FlavioDB/FPGA-Based-BLDC-Motor-Controller-with-RISC-V-SoC/Screenshots_Waveforms/Brakes/Brakes brain.jpg

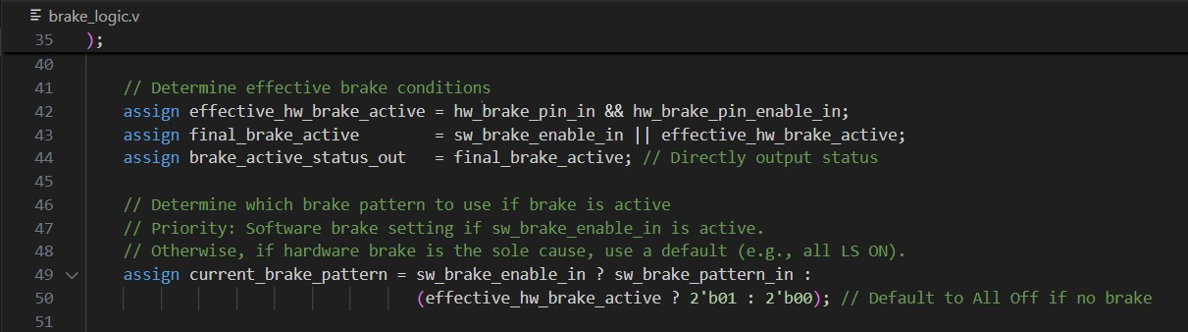
Screenshots_Waveforms/Brakes/Brakes brain.jpg
