FlavioDB/FPGA-Based-BLDC-Motor-Controller-with-RISC-V-SoC/README.txt

Francesco Tassi 2359266
Flavio Davide Borriello 2359270
Professor Jiang Lei - Intelligent Chip Design

In the Appendix, the following files are available:
• Tang Primer 20k and BLDC H-Bridge Schematics
• Constraints file (.cst) for our project
• Class notes showing the project’s structure
• various main.c files that have been used for the various simulations. It's enough to substitute them to the main.c file inside the project folder to try the different verions out 

In the folder e203BLDCfaf-main - current version we have, of course, the whole project with all .v and .c files.

July 2025
