FlavioDB/FPGA-Based-BLDC-Motor-Controller-with-RISC-V-SoC/Appendix/Project Documentation and notes.docx

# Understanding the Hummingbird E203 and its Role

- The Brain: The E203 is a 32-bit RISC-V processor core. Think of it as the CPU of your system-on-chip (SoC). It will execute the C code you write to manage the BLDC motor (e.g., set speed, direction, mode).
- Bus Master: In the context of the ICB, the E203 core acts as the master. This means it initiates all communication transactions (reads and writes) to peripherals like your BLDC controller.
- Memory-Mapped Peripherals: The E203 interacts with peripherals by treating their control and status registers as locations in its memory map. When your C code writes to a specific memory address, the E203 translates this into an ICB write transaction to that address. Your BLDC controller will be assigned a range of these addresses.

The ICB (Internal Chip Bus) Protocol

The ICB is a relatively simple, synchronous, point-to-point (or shared, with an arbiter) bus designed for on-chip communication. Your BLDC controller will be an ICB slave.

Here are the key signals you'll need to implement in your Verilog module for the slave interface:

Signals from Master (E203) to Slave (Your BLDC Controller):

- icb_cmd_valid (Input to your module):
  - When asserted (HIGH), it indicates that the master (E203) is presenting a valid command (address and potentially write data) on the bus.
- icb_cmd_addr[AWIDTH-1:0] (Input to your module):
  - The address target of the command. AWIDTH is the address bus width (typically 32 bits for E203, but your peripheral will only look at a few lower bits to select internal registers).
- icb_cmd_read (Input to your module):
  - When HIGH, it's a read command. When LOW, it's a write command.
- icb_cmd_wdata[DWIDTH-1:0] (Input to your module):
  - The data to be written if icb_cmd_read is LOW. DWIDTH is the data bus width (typically 32 bits).

Signal from Slave (Your BLDC Controller) to Master (E203):

- icb_cmd_ready (Output from your module):
  - When asserted (HIGH), it indicates that your slave peripheral is ready to accept the command currently presented by the master. This is crucial for flow control. If your peripheral is busy, it can de-assert icb_cmd_ready to make the master wait.
  - A transaction on the command channel happens on a clock edge when both icb_cmd_valid and icb_cmd_ready are HIGH.

Signals from Slave (Your BLDC Controller) to Master (E203) for Response:

- icb_rsp_valid (Output from your module):
  - When asserted (HIGH), it indicates that your slave is providing a valid response (e.g., read data or write acknowledgement) to the master.
- icb_rsp_rdata[DWIDTH-1:0] (Output from your module):
  - The data being returned to the master for a read command. For a write command, this data is usually ignored by the master, but it's good practice to drive it to zeros or a defined value.

Signal from Master (E203) to Slave (Your BLDC Controller) for Response:

- icb_rsp_ready (Input to your module):
  - When asserted (HIGH), it indicates that the master is ready to accept the response from your slave. This is also for flow control on the response channel.
  - A transaction on the response channel happens on a clock edge when both icb_rsp_valid and icb_rsp_ready are HIGH.

How Your BLDC Controller Acts as an ICB Slave:

1. Address Decoding:
  - Your module will be assigned a base address in the E203's memory map (e.g., 0x10040000 as seen in the example report for a UART, page 23, u_sirv_uart1). Your peripheral will have a similar entry.
  - When icb_cmd_valid is high, your module will check if the upper bits of icb_cmd_addr match its assigned base address.
  - If they match, it knows the command is for it. The lower bits of icb_cmd_addr (e.g., icb_cmd_addr[3:2] if your registers are 4-byte aligned and you have a few registers) will be used to select which specific internal register within your BLDC controller is being accessed.
2. Handling Write Transactions:
  - Master asserts icb_cmd_valid, icb_cmd_addr (to your peripheral), icb_cmd_wdata, and sets icb_cmd_read = 0.
  - Your slave logic decodes the address. If the address is for one of your writable registers and you are ready, you assert icb_cmd_ready.
  - On the next rising clock edge where icb_cmd_valid and icb_cmd_ready are both high, your logic latches icb_cmd_wdata into the selected internal register.
  - Your slave then needs to generate a response. Typically for a write, this is just an acknowledgement. You assert icb_rsp_valid. The master asserts icb_rsp_ready when it's ready for the response. The icb_rsp_rdata is often not critical for writes but can indicate success/failure if your bus protocol defines it.
3. Handling Read Transactions:
  - Master asserts icb_cmd_valid, icb_cmd_addr (to your peripheral), and sets icb_cmd_read = 1.
  - Your slave logic decodes the address. If the address is for one of your readable registers and you are ready for the command, assert icb_cmd_ready.
  - On the clock edge where icb_cmd_valid and icb_cmd_ready are high, the command is accepted.
  - Your slave logic then retrieves the data from the selected internal register.
  - You place this data on icb_rsp_rdata and assert icb_rsp_valid.
  - The master, when ready, asserts icb_rsp_ready. On the clock edge where both are high, the master captures icb_rsp_rdata.

Practical Implementation - icb_interface.v

- The Verilog module that handles this ICB slave logic is often called something like icb_slave_if.v or, as I suggested, icb_interface.v within your bldc_controller.v.
- The previous student's report on page 22 shows an example snippet of ICB_SlaveIF.v. This is a very good reference for the state machine and logic required to handle the valid/ready handshakes for both command and response channels.
  - Notice the cmd_valid_i (input icb_cmd_valid) and cmd_ready_o (output icb_cmd_ready).
  - And rsp_valid_o (output icb_rsp_valid) and rsp_ready_i (input icb_rsp_ready).
  - It internally generates signals like write_ena (write enable for your registers) and read_ena when a valid transaction for your peripheral occurs.

Key Design Steps for Your ICB Interface:

1. Define Your Register Map: This is absolutely critical and should be done before you finalize the ICB Verilog. You need to know:
  - How many registers do you need?
  - What is the address offset of each register from your peripheral's base address?
  - Are they read-only, write-only, or read-write?
  - What are the bitfields within each register? (e.g., Control register: bit 0 = enable, bits 4:1 = mode, etc.)
2. Implement Address Decoder: Logic that checks if icb_cmd_addr falls within your peripheral's range and then uses the lower bits to select an internal register.
3. Implement Read/Write Logic:
  - For writes: Use the decoded address and a write strobe (derived from icb_cmd_valid, icb_cmd_ready, and !icb_cmd_read) to update the target register with icb_cmd_wdata.
  - For reads: Use the decoded address to select data from the target register and output it on icb_rsp_rdata.
4. Implement Handshake Logic: Manage icb_cmd_ready and icb_rsp_valid correctly. A common approach is to make icb_cmd_ready high by default if the peripheral is not busy and the address is recognized. icb_rsp_valid is asserted once read data is available or a write has been processed.

Next Immediate Step:

Before we dive into the Verilog for the ICB interface itself, let's solidify your register map. Based on the project requirements and the previous report (page 26), what registers and bitfields do you think you'll need for your BLDC controller? Sketching this out will make the ICB interface design much clearer.

For example:

- 0x00: Control Register (RW)
  - bit 0: enable_motor
  - bit 1: direction
  - bits [3:2]: mode (00=static, 01=PWM, 10=SPWM)
- 0x04: Period Register (RW)
  - bits [15:0]: period_value (for timer or step duration)
- 0x08: Duty Cycle / OC1 Register (RW)
  - bits [15:0]: duty_value
- 0x0C: Dead Zone Register (RW)
  - bits [7:0]: dead_zone_cycles
- 0x10: Status Register (RO)
  - bit 0: break_active_status

# Verilog Code

## General

Let's assume your top-level module is bldc_controller.v.

1. icb_interface.v (ICB Slave Interface)
  - Purpose: Handles all communication with the E203 processor via the ICB bus. It decodes addresses, manages read/write operations to your internal registers, and implements the valid/ready handshaking.
  - Key Inputs:
    - clk (system clock, e.g., 27MHz)
    - rst_n (reset)
    - icb_cmd_valid, icb_cmd_addr, icb_cmd_read, icb_cmd_wdata (from E203)
    - icb_rsp_ready (from E203)
    - reg_read_data_muxed (data from your register file for read operations)
  - Key Outputs:
    - icb_cmd_ready (to E203)
    - icb_rsp_valid, icb_rsp_rdata (to E203)
    - reg_write_en (to register file, indicates a write to a register)
    - reg_write_addr_sel (to register file, selected register address bits)
    - reg_write_data (to register file, data to be written)
    - reg_read_addr_sel (to register file, selected register address bits for reading)
  - Internal Logic: Address decoding, state machine for ICB protocol.
2. register_file.v (Configuration & Status Registers)
  - Purpose: Holds all the software-configurable parameters (like mode, period, dead-zone value) and status information (like brake active).
  - Key Inputs:
    - clk
    - rst_n
    - reg_write_en, reg_write_addr_sel, reg_write_data (from icb_interface)
    - reg_read_addr_sel (from icb_interface)
    - hw_status_inputs (e.g., break_pin_status, current FSM state if needed for status registers)
  - Key Outputs:
    - reg_read_data_muxed (to icb_interface, selected register's data)
    - Individual register outputs (e.g., control_reg_out, period_reg_out, deadzone_reg_out) to other modules.
  - Internal Logic: A set of registers. Multiplexer to select read data based on reg_read_addr_sel. Logic to update registers on reg_write_en.
3. clock_prescaler.v (Optional, but likely needed)
  - Purpose: To generate a slower clock for your main timer/PWM logic if the system clock (e.g., 27MHz) is too fast for the desired PWM carrier frequencies (e.g., target 20-50kHz for PWM). The previous report used a 34kHz clock.
  - Key Inputs:
    - clk_in (e.g., 27MHz)
    - rst_n
    - (Optional) divisor_value (if you want it configurable, though often fixed)
  - Key Outputs:
    - clk_out (e.g., 34kHz, this will be the pwm_clk or timer_clk)
  - Internal Logic: A counter that divides the input clock.
4. main_timer.v (16-bit Counter)
  - Purpose: The core timer that counts up to a period value. This period can define a PWM cycle, a step in 6-step commutation, or be used for SPWM timing.
  - Key Inputs:
    - pwm_clk (from clock_prescaler or system clk if no prescaler)
    - rst_n
    - enable (from register_file control register)
    - load_period (a pulse to load a new period value)
    - period_value_in (from register_file)
  - Key Outputs:
    - timer_count_out (current 16-bit count value)
    - period_match_tick (pulse when timer reaches period_value_in - 1 and wraps)
  - Internal Logic: A 16-bit counter, comparator for period match.
5. pwm_waveform_generator.v (or output_logic.v)
  - Purpose: This is the most complex module. It takes the timer count, OC values (duty cycle settings), mode selection, and direction to generate the 6 ideal (pre-dead-zone) PWM signals for the U, V, W phases.
  - Key Inputs:
    - pwm_clk
    - rst_n
    - enable (from register_file)
    - mode (Static, PWM, SPWM - from register_file)
    - direction (from register_file)
    - timer_count_out (from main_timer)
    - period_match_tick (from main_timer)
    - oc_value_U, oc_value_V, oc_value_W (these are the effective duty cycle controls for each phase, derived from registers or SPWM logic)
    - period_value_for_pwm (current period for PWM generation, could be from main_timer or a separate register for SPWM)
    - (For SPWM) sine_data_U, sine_data_V, sine_data_W (from spwm_engine)
  - Key Outputs:
    - ideal_pwm_hs_u, ideal_pwm_ls_u
    - ideal_pwm_hs_v, ideal_pwm_ls_v
    - ideal_pwm_hs_w, ideal_pwm_ls_w (Note: ideal_pwm_ls_x is simply !ideal_pwm_hs_x before dead-zone insertion)
  - Internal Logic:
    - State machine for 6-step commutation (for Static and PWM modes).
    - Comparators: timer_count_out < oc_value_X to generate basic PWM.
    - Logic to select active phases based on commutation step and direction.
    - Logic to modulate PWM duty based on sine_data_X in SPWM mode.
6. spwm_engine.v (SPWM Specific Logic - if separated)
  - Purpose: Generates the three phase-shifted sinusoidal modulation values for SPWM mode.
  - Key Inputs:
    - pwm_clk
    - rst_n
    - enable (from register_file, specifically when in SPWM mode)
    - spwm_frequency_control (derived from a register, to set the 1-10Hz output sine frequency)
    - spwm_amplitude_control (derived from a register)
  - Key Outputs:
    - sine_data_U, sine_data_V, sine_data_W (to pwm_waveform_generator)
  - Internal Logic:
    - sine_rom.v (instantiated internally or accessed)
    - Angle counters/accumulators for each phase (offset by 120 degrees).
    - Logic to fetch values from ROM based on current angles.
    - Logic to scale sine values by amplitude control.
    - The phase_generator.v from page 34 of the report would fit here.
7. dead_zone_inserter.v
  - Purpose: Takes the 3 pairs of ideal complementary PWM signals and inserts the configured dead time.
  - Key Inputs:
    - pwm_clk
    - rst_n
    - ideal_pwm_hs_u, ideal_pwm_ls_u (and for V, W) (from pwm_waveform_generator)
    - dead_zone_cycles (from register_file)
  - Key Outputs:
    - final_pwm_hs_u, final_pwm_ls_u (and for V, W) (these go to the FPGA output pins)
  - Internal Logic: Delay logic. When HS turns off, LS is delayed from turning on. When LS turns off, HS is delayed from turning on. Typically uses small counters or shift registers per phase.
8. brake_logic.v
  - Purpose: Overrides the normal PWM outputs when an emergency brake signal is asserted.
  - Key Inputs:
    - break_input_pin (from FPGA top-level input)
    - final_pwm_hs_u_pre_brake, final_pwm_ls_u_pre_brake (etc. for V, W - these are the outputs from dead_zone_inserter)
  - Key Outputs:
    - pwm_out_hs_u, pwm_out_ls_u (etc. for V, W - these are the final outputs to FPGA pins)
    - break_active_status_to_reg (to register_file)
  - Internal Logic: Multiplexer-like logic. If break_input_pin is active, output predefined brake pattern (e.g., all HS low, all LS high). Otherwise, pass through signals from dead_zone_inserter.

Top-Level Module: bldc_controller.v

- Purpose: Instantiates all the above sub-modules and connects them together. It defines the external interface of your entire BLDC controller IP.
- Inputs:
  - clk (system clock for ICB)
  - rst_n
  - ICB signals (icb_cmd_valid, etc.)
  - External pins (io_pad_in_BREAK)
- Outputs:
  - ICB signals (icb_cmd_ready, etc.)
  - 6 PWM output signals to FPGA pins (io_pad_out_HS_U, io_pad_out_LS_U, etc.)

## What’s done

### Module 1: clock_prescaler.v

This module will take the 27 MHz system clock and generate the 2.7 MHz pwm_clk.

Key points for clock_prescaler.v:

- Parameter N: This makes it clear how the division factor is set. N=4 means the counter counts 0, 1, 2, 3, 4 (5 cycles). The output toggles when the counter reaches N. So, one full period of pwm_clk_out takes 2 * (N+1) cycles of clk_in.
- Counter Size: $clog2(N) ensures the counter is just wide enough. If N=4, $clog2(4) is 2. So counter will be reg [2:0], which can count 0 to 7. This is correct as it needs to hold values up to 4.
- Initialization: pwm_clk_out is initialized to 1'b0 on reset. This is good practice.

### Module 2: main_timer.v

This module is the 16-bit counter that will generate our PWM carrier period. It will be clocked by the pwm_clk_out from the prescaler.

Key points for main_timer.v:

- clk: This will be driven by pwm_clk_out (2.7 MHz).
- enable: From a control register bit.
- load_period: A signal to tell the timer to latch period_value_in. You'll need to decide how this pulse is generated. Often, writing to the period register in your register_file could trigger a one-cycle pulse for load_period. For now, it's an input.
- period_value_in: This is the value that software will write (e.g., 270). The timer counts 0 to period_value_in - 1. So, if period_value_in is 270, it counts 0..269.
- current_period_val: An internal register to hold the active period. This prevents issues if period_value_in changes mid-count.
- Zero Period Handling: Added a small check (period_value_in == 0) ? 16'd1 : period_value_in; to ensure the period is at least 1. A period of 0 is problematic.
- period_match_tick: Asserted for one clock cycle when the counter is about to wrap.
- Disabled State: When enable is low, the timer count is reset to 0. This is a common behavior.

### Module 3: register_file.v

This module will hold the configuration and status registers that the E203 processor will interact with via the ICB bus.

Defining the Register Map

For simplicity, all registers are 32-bit, aligned to 4-byte boundaries.

- 0x00: CONTROL_REG (R/W)
  - [1:0] : Op_Mode
  - [2] : Direction
  - [3] : Enable_Motor
  - [4] : Soft_Reset_Internal (Pulse, W1S)
  - [5] : SW_Brake_Enable
  - [7:6] : SW_Brake_Pattern
  - [8] : HW_Brake_Pin_Enable
  - [31:9]: Reserved
- 0x04: CARRIER_TIMING_REG (R/W)
  - [15:0]: PWM_Carrier_Period (for PWM carrier timer)
  - [19:16]: Dead_Zone_Value (4-bit)
  - [31:20]: Reserved
- 0x08: COMMUTATION_TIMING_REG (R/W)
  - [15:0]: Commutation_Step_Period (for step duration timer in 6-step modes)
  - [31:16]: Reserved
- 0x0C: PWM_DUTY_REG (R/W)
  - [15:0]: PWM_Duty_Value_Generic (Applied to active phase in PWM 6-step mode)
  - [31:16]: Reserved
- 0x10: SPWM_CONFIG_REG (R/W)
  - [15:0]: SPWM_Phase_Increment (for SPWM frequency)
  - [23:16]: Reserved
  - [31:24]: SPWM_Amplitude_Global (8-bit global amplitude for SPWM)
- 0x14: STATUS_REG (Read-Only)
  - [0] : Brake_Active_HwStatus
  - [1] : Motor_Enabled_HwStatus
  - [4:2]: Reserved
  - [6:5] : Current_Actual_Op_Mode_HwStatus
  - [9:7] : Current_Commutation_State_6Step_HwStatus (3 bits for 0-5)
  - [15:10]: Reserved
  - [31:16]: Current_SPWM_Phase_Accumulator_U_HwStatus (16-bit, example for phase U)

Key Features and Design Choices:

1. reg_addr_sel [2:0]: Since there are 6 registers (indices 0 to 5), a 3-bit address selector is sufficient.
2. localparam for Addresses: Clear and maintainable.
3. Reset Values: Sensible default values are provided for all configuration registers.
4. soft_reset_internal_pulse_reg: Implements the W1S (Write-1-to-Set, hardware self-clears) behavior for soft_reset_internal_out.
5. Write Logic:
  - REG_CONTROL[4] (soft reset bit) is handled to ensure it's always read as 0 from the register itself after a write that sets the pulse.
  - Writes to ADDR_STATUS are ignored (it's Read-Only).
6. Continuous Assignments for Outputs: Directly map register bitfields to the output control signals. This is clean and easy to follow.
7. Status Register Construction:
  - The STATUS_REG value is constructed combinationally within the always @(*) block using the status_val_constructed temporary variable when ADDR_STATUS is read.
  - This ensures the read value always reflects the live hardware status inputs.
8. Default Read Value: 32'hDEADBEEF for invalid read addresses (though with a 3-bit reg_addr_sel correctly generated by the icb_interface, this default shouldn't be hit if only 6 addresses are valid).

Key Features Testbench:

1. CLK_PERIOD: Defines the simulation clock.
2. DUT Instantiation: Connects all ports of your register_file.v.
3. write_reg Task: A helper task to simplify writing to a register. It handles asserting reg_write_en_tb for one clock cycle.
4. read_reg_and_check Task: A helper task to read a register and compare its value (optionally masked) against an expected value. It includes error reporting.
5. Initialization: Sets initial values for testbench signals and applies reset.
6. Verify Reset Values: After reset, reads all registers to check if they hold their defined reset values.
7. Individual Register Tests:
  - For each R/W register, it writes a test pattern and then reads it back, checking both the read data and the corresponding output control signals.
  - CONTROL_REG: Includes a specific test for the soft_reset_internal_out pulse.
8. STATUS_REG Test:
  - Changes the hardware input signals (brake_active_hw_in_tb, etc.).
  - Reads the STATUS_REG to verify it correctly reflects these hardware inputs.
  - Attempts to write to STATUS_REG (which should have no effect as it's RO) and reads back to confirm.
9. Masking for Reads: The read_mask in read_reg_and_check is important for R/W registers because some bits might be reserved or write-only (like the soft_reset bit that self-clears). For RO registers, the mask is usually all 1s.

### Module 4: dead_zone_channel.v

Purpose:
This module takes three pairs of ideal complementary PWM signals (one high-side, one low-side for each phase U, V, W) and inserts a "dead zone" or "dead time." This means ensuring that for any phase, the high-side switch turns OFF a short time before the low-side switch turns ON, and vice-versa. This prevents shoot-through (a direct short circuit from the power supply through both MOSFETs to ground), which can instantly destroy your MOSFETs or the driver board.

Why this module next?

1. Critical for Hardware Safety: This is non-negotiable for driving a real motor with an H-bridge.
2. Relatively Standalone: For simulation, you can easily create ideal complementary PWM input signals in a testbench. It primarily needs a clock and the dead-zone duration value (which will eventually come from dead_zone_value_out of your register_file.v, but can be a direct input for now).
3. Clear Simulation Goal: In GtkWave, you'll be looking for a distinct time gap between the falling edge of one switch's signal and the rising edge of its complement.

Key Inputs & Outputs for dead_zone_inserter.v (Conceptual):

- Inputs:
  - clk: This should be your PWM clock (e.g., the clock generated by clock_prescaler.v). The dead zone duration will be counted in terms of these clock cycles.
  - rst_n: Asynchronous reset.
  - dead_zone_cycles [7:0]: The number of clk cycles for the dead time. (This will connect to dead_zone_value_out from register_file.v).
  - ideal_pwm_hs_u_in, ideal_pwm_ls_u_in: Ideal high-side and low-side PWM for phase U. (Note: ideal_pwm_ls_u_in will simply be !ideal_pwm_hs_u_in from pwm_waveform_generator.v).
  - ideal_pwm_hs_v_in, ideal_pwm_ls_v_in: For phase V.
  - ideal_pwm_hs_w_in, ideal_pwm_ls_w_in: For phase W.
- Outputs:
  - final_pwm_hs_u_out, final_pwm_ls_u_out: Phase U PWM signals with dead time inserted. (These will go to brake_logic.v and then to the FPGA pins).
  - final_pwm_hs_v_out, final_pwm_ls_v_out: For phase V.
  - final_pwm_hs_w_out, final_pwm_ls_w_out: For phase W.

Implementation Strategy (for one phase, e.g., U):

You'll essentially need to delay the rising edges of your PWM signals.

1. HS_U Logic:
  - When ideal_pwm_hs_u_in falls (1 -> 0), final_pwm_hs_u_out should fall immediately.
  - When ideal_pwm_hs_u_in rises (0 -> 1), final_pwm_hs_u_out should only rise if final_pwm_ls_u_out has been LOW for at least dead_zone_cycles. (This is the tricky part - typically, you ensure the other switch is off, then wait for dead time, then turn on).

A common way:

  - final_pwm_hs_u_out turns OFF when ideal_pwm_hs_u_in turns OFF.
  - final_pwm_hs_u_out turns ON only if ideal_pwm_ls_u_in is OFF, and then after a delay of dead_zone_cycles after ideal_pwm_ls_u_in turned OFF.

Let's simplify the input from pwm_waveform_generator.v. It will likely just output the high-side signals (e.g., pwm_u, pwm_v, pwm_w). The dead-zone inserter will generate both HS_U and LS_U.
Assume pwm_u_ideal_in is the command for the U-phase (high means U-phase high-side FET should be on, low means U-phase low-side FET should be on, conceptually, before dead time).

Revised inputs (simpler):

  - clk, rst_n
  - dead_zone_cycles [7:0]
  - pwm_u_drive_ideal_in: This is the signal that would ideally drive HS_U if there were no dead time, and its inverse would drive LS_U.
  - pwm_v_drive_ideal_in
  - pwm_w_drive_ideal_in

Then, for phase U:

  - final_pwm_hs_u_out:
    - Goes LOW when pwm_u_drive_ideal_in goes LOW.
    - Goes HIGH only dead_zone_cycles after final_pwm_ls_u_out has gone LOW.
  - final_pwm_ls_u_out:
    - Goes LOW when pwm_u_drive_ideal_in goes HIGH.
    - Goes HIGH only dead_zone_cycles after final_pwm_hs_u_out has gone LOW.

This requires some state or small counters for each half-phase. You can instantiate this logic three times, once for each phase.

A More Standard Approach (Non-Overlapping Clock Generation):

Let A be the ideal high-side drive and B be the ideal low-side drive (B = !A).
We want A_out and B_out.

- A_out turns off when A turns off.
- A_out turns on when A turns on AND dead_time_after_B_off has passed.
- B_out turns off when B turns off.
- B_out turns on when B turns on AND dead_time_after_A_off has passed.

We can use two small state machines or edge detectors and counters. Here's a common and robust approach:

- Detect edges on ideal_hs_in:
  - Falling edge (1 -> 0): HS needs to turn OFF, LS prepares to turn ON.
  - Rising edge (0 -> 1): LS needs to turn OFF, HS prepares to turn ON.
- Use delay counters for turn-on:
  - hs_turn_on_delay_counter: Counts down when HS is preparing to turn ON.
  - ls_turn_on_delay_counter: Counts down when LS is preparing to turn ON.

Explanation:

1. ideal_hs_in_d1: Stores the value of ideal_hs_in from the previous clock cycle. This is standard for edge detection.
2. Edge Detection:
  - ideal_hs_rising_edge: True for one clock cycle when ideal_hs_in transitions from 0 to 1.
  - ideal_hs_falling_edge: True for one clock cycle when ideal_hs_in transitions from 1 to 0.
3. High-Side Logic (final_hs_out):
  - If a ideal_hs_falling_edge occurs (meaning ideal_hs_in is now 0), final_hs_out is immediately set to 0. Any pending HS turn-on is cancelled. The ls_turn_on_delay_counter is started.
  - If the hs_turn_on_delay_counter is active (counting down), it continues. When it reaches 1 (meaning it will be 0 on the next clock edge after this one), final_hs_out is set to 1.
4. Low-Side Logic (final_ls_out):
  - If an ideal_hs_rising_edge occurs (meaning ideal_hs_in is now 1), final_ls_out is immediately set to 0. Any pending LS turn-on is cancelled. The hs_turn_on_delay_counter is started.
  - If the ls_turn_on_delay_counter is active, it continues. When it reaches 1, final_ls_out is set to 1.
5. Zero Dead Time Handling: Added a check for dead_zone_cycles == 0. In this case, the complementary switch turns on immediately. This might be useful for testing or if the external driver IC itself has fixed dead time.
6. Reset State: On reset, both outputs are 0. You might consider setting one ON (e.g., final_ls_out <= 1'b1;) if that's a safer default for your system, but both OFF is generally a safe starting point.

Explanation of the Testbench:

1. timescale: Defines simulation time units.
2. Parameters:
  - CLK_PERIOD: Set this to define your simulation clock. If your dead_zone_channel's clk input is intended to be the 34kHz PWM clock, then CLK_PERIOD would be 1 / 34000 Hz = 29.412 us. For faster simulation runs, you can use a faster clock (e.g., 20ns for 50MHz) and ensure DEAD_ZONE_CONFIG and IDEAL_PWM_PERIOD are scaled accordingly in terms of these faster clock cycles. The key is the number of clock cycles.
  - DEAD_ZONE_CONFIG: The value for dead_zone_cycles.
  - IDEAL_PWM_PERIOD: How many clock cycles the ideal_hs_in_tb signal will stay high or low.
3. Signal Declarations:
  - reg for inputs to the DUT.
  - wire for outputs from the DUT.
4. DUT Instantiation: dead_zone_channel UUT (...).
5. Clock Generation: An always block to create the clk signal.
6. Stimulus (initial block):
  - Reset: Applies reset at the beginning.
  - Test Case 1: Basic operation with the default DEAD_ZONE_CONFIG. It toggles ideal_hs_in_tb to create a square wave.
  - Test Case 2: Tests with dead_zone_cycles_tb = 0. The outputs should now be perfectly complementary with no visible dead time.
  - Test Case 3: Tests with a larger dead time.
  - Test Case 4: (Conditional) Tests with faster toggling of ideal_hs_in_tb to ensure dead time is still respected even if the on-time is short (but still longer than the dead time).
  - $display: Prints messages to the console during simulation.
  - $finish: Ends the simulation.
7. Shoot-through Monitor (always block):
  - This is a very important check. It continuously monitors if final_hs_out_tb and final_ls_out_tb are ever high at the same time. If they are, it prints an error and stops the simulation.
8. Waveform Dumping (initial block with $dumpfile, $dumpvars):
  - This tells the simulator (like Icarus Verilog) to create a VCD (Value Change Dump) file named tb_dead_zone_channel.vcd.
  - You can then open this VCD file with GtkWave to visualize the signals.

### Module 5: dead_zone_inserter.v

top-level dead_zone_inserter.v module, which will instantiate dead_zone_channel three times (once for U, V, and W phases).

Explanation of this Testbench:

1. Parameters:
  - CLK_PERIOD, DEAD_ZONE_CONFIG are similar to before.
  - COMMUTATION_STEP_DURATION: Defines how long each ideal_hs_in signal stays high or low in the main test sequence.
2. DUT Instantiation: Instantiates dead_zone_inserter.
3. Stimulus Generation:
  - The first loop (for (commutation_cycle = 0; commutation_cycle < 4; ...) generates three square waves for ideal_hs_u_in_tb, ideal_hs_v_in_tb, and ideal_hs_w_in_tb. These are deliberately made to overlap somewhat by using #delay between starting their active phases. This isn't a true motor commutation but serves to exercise each dead_zone_channel instance within the DUT independently and at different times.
  - The second loop tests with dead_zone_value_tb = 0. Here, it generates a more "one-hot" like sequence for the ideal HS signals to make it easier to see the complementary outputs.
4. Shoot-through Monitor: Now checks all three phases for simultaneous HS and LS activation.

### To implement Static Mode in pwm_waveform_generator.v:

1. State Machine: A 3-bit state register to represent the 6 commutation steps (e.g., state 0 to 5).
2. Timer for Step Duration: Use your main_timer.v. The timer_period_out from register_file.v would define the duration of one full electrical cycle or one commutation step. Let's assume for now it's one commutation step duration. When main_timer.v signals a period_match_tick, the state machine advances to the next commutation step.
3. Output Logic: Based on the current state and the direction_out signal (from register_file.v), determine which of ideal_hs_u_in, ideal_hs_v_in, ideal_hs_w_in should be '1' and which should be '0'.
  - Example (one direction):
    - State 0: ideal_hs_u_in=1, ideal_hs_v_in=0, ideal_hs_w_in=0 (U+ active, assume V- is the return path via its low-side FET)
    - State 1: ideal_hs_u_in=1, ideal_hs_v_in=0, ideal_hs_w_in=0 (U+ active, assume W- is the return path) (This needs careful thought about which two phases are active. Standard 6-step involves current flowing through two phases. e.g. U+ to V- means HS_U is ON, LS_V is ON).

Let's refine the 6-step output for ideal_hs_in:
If ideal_hs_x_in = 1 means HS_X is commanded ON (and LS_X commanded OFF), and
If ideal_hs_x_in = 0 means HS_X is commanded OFF (and LS_X commanded ON).

A common 6-step sequence (commanding which HS is ON, the other phase in the pair has LS ON):

- Step 1: U_HS ON, V_LS ON => ideal_hs_u=1, ideal_hs_v=0 (this implies final_ls_v will be on), ideal_hs_w can be 0.
- Step 2: U_HS ON, W_LS ON => ideal_hs_u=1, ideal_hs_w=0 (this implies final_ls_w will be on), ideal_hs_v can be 0.
- Step 3: V_HS ON, W_LS ON => ideal_hs_v=1, ideal_hs_w=0 (final_ls_w), ideal_hs_u=0.
- Step 4: V_HS ON, U_LS ON => ideal_hs_v=1, ideal_hs_u=0 (final_ls_u), ideal_hs_w=0.
- Step 5: W_HS ON, U_LS ON => ideal_hs_w=1, ideal_hs_u=0 (final_ls_u), ideal_hs_v=0.
- Step 6: W_HS ON, V_LS ON => ideal_hs_w=1, ideal_hs_v=0 (final_ls_v), ideal_hs_u=0.

The module would take timer_period_out (from register_file) to set the period of main_timer. The period_match_tick from main_timer would advance the 6-step state machine.

Internal Logic for Static Mode:

1. Commutation State Register:
  - A 3-bit register to hold the current commutation state (0 to 5).
  - reg [2:0] commutation_state;
2. State Transition Logic:
  - On rst_n, commutation_state resets to 0.
  - When enable_motor_in is high and step_period_match_tick_in occurs:
    - If direction_in is forward (0), commutation_state increments (0 -> 1 -> 2 -> 3 -> 4 -> 5 -> 0).
    - If direction_in is reverse (1), commutation_state decrements (0 -> 5 -> 4 -> 3 -> 2 -> 1 -> 0).
3. Output Mapping Logic (Combinational):
  - Based on the current commutation_state (and potentially direction_in, though typically the sequence handles direction), determine the values of ideal_hs_u_out, ideal_hs_v_out, ideal_hs_w_out.
  - 6-Step Sequence (Forward - direction_in == 0): Remember, ideal_hs_X_out = 1 commands HS_X to be ON (and implies LS_X is OFF). The complementary phase in the pair will have its LS_X ON (implying its HS_X is OFF, so its ideal_hs_X_out will be 0).
    - State 0 (U+ V-): ideal_hs_u_out=1, ideal_hs_v_out=0, ideal_hs_w_out=0
    - State 1 (U+ W-): ideal_hs_u_out=1, ideal_hs_v_out=0, ideal_hs_w_out=0 (Here, V is effectively off, W's LS is on)
    - State 2 (V+ W-): ideal_hs_u_out=0, ideal_hs_v_out=1, ideal_hs_w_out=0
    - State 3 (V+ U-): ideal_hs_u_out=0, ideal_hs_v_out=1, ideal_hs_w_out=0
    - State 4 (W+ U-): ideal_hs_u_out=0, ideal_hs_v_out=0, ideal_hs_w_out=1
    - State 5 (W+ V-): ideal_hs_u_out=0, ideal_hs_v_out=0, ideal_hs_w_out=1
  - 6-Step Sequence (Reverse - direction_in == 1): This is the reverse of the forward sequence.
    - State 0 (U+ W- effectively, but we are using state names as fixed points and changing sequence): Maps to Forward State 0: U_HS ON, V_LS ON. Reverse order of states: 0 (acts like Fwd 0: U+V-), then goes to state 5 (acts like Fwd 5: W+V-), then state 4 (acts like Fwd 4: W+U-), etc. Let's define the output based on state clearly for both directions. A common way is to define one sequence (e.g., forward) and then for reverse, either swap two phase outputs (e.g., V and W) or go through the states in reverse order. Reversing state order is cleaner.

Explanation of the Testbench:

1. Parameters:
  - CLK_PWM_PERIOD: Defines the period of clk_pwm_tb.
  - STEP_TICK_INTERVAL: Determines how often step_period_match_tick_in_tb will pulse high. This simulates your main timer providing a tick at the end of each commutation step.
2. DUT Instantiation: Instantiates pwm_waveform_generator. Unused inputs for static mode (like OC values) are left unconnected.
3. Clock Generation (clk_pwm_tb): Standard clock generator.
4. step_period_match_tick_in_tb Generation: An initial block with a forever loop creates a periodic single-cycle pulse for this input.
5. Stimulus (initial block):
  - Reset: Applied at the beginning.
  - Test Case 1 (Forward): Enables the motor in Static Mode with forward direction. Runs for enough time to observe multiple 6-step cycles.
  - Test Case 2 (Reverse): Changes direction to reverse.
  - Test Case 3 (Disable): Sets enable_motor_in_tb to low. Outputs should go to their default (off) state.
  - Test Case 4 (Re-enable): Re-enables the motor to see if it resumes correctly (depending on whether your DUT resets commutation_state when disabled).
6. Waveform Dumping: Configured for tb_pwm_static.vcd.

### Inputs Required for PWM Mode (add these to pwm_waveform_generator.v):

- pwm_timer_count_in [15:0]: The current count value of your main PWM carrier timer (the one that counts from 0 up to pwm_timer_period_in - 1). This is different from the step_period_match_tick_in which determines step duration.
- oc_u_val_in [15:0]: Output Compare value for phase U (determines duty cycle).
- oc_v_val_in [15:0]: Output Compare value for phase V.
- oc_w_val_in [15:0]: Output Compare value for phase W.
  - (Note: The actual pwm_timer_period_in is implicitly the value that pwm_timer_count_in counts up to. The OC values should be less than this period.)

Modifications to pwm_waveform_generator.v:

1. Port List: Add the new inputs listed above.
2. Output Logic (always @(*) block):
  - Inside the case (op_mode_in), we'll add specific logic for MODE_PWM.
  - When op_mode_in == MODE_PWM:
    - We still use the commutation_state to determine the active phases.
    - For the phase whose High-Side is active according to the current commutation_state:
      - Its ideal_hs_X_out will be (pwm_timer_count_in < oc_X_val_in).
    - For phases whose High-Side is not active (meaning their Low-Side might be, or they are off), their ideal_hs_X_out will be 1'b0.

### Revised pwm_waveform_generator.v to include timers

New Inputs (replacing simulated timer signals):

- clk_system: A base clock from which clk_pwm might be derived, or clk_pwm can be used directly if it's the correct frequency for both timers. Let's assume clk_pwm is suitable for now.
- step_duration_period_in [15:0]: From register_file.v, sets the period for the step duration timer.
- pwm_carrier_period_in [15:0]: From register_file.v, sets the period for the PWM carrier timer. (These would replace step_period_match_tick_in and pwm_timer_count_in as direct inputs. The OC value inputs remain.)

Internal Changes:

- Instantiate main_timer as step_timer.
- Instantiate main_timer as pwm_carrier_timer.
- Connect their outputs appropriately to the existing logic.
1. Timer Instantiation: Two main_timer instances (step_timer and pwm_carrier_timer) are added.
2. New Inputs: step_duration_period_in and pwm_carrier_period_in are now inputs to set the periods of these internal timers. These would come from your register_file.v.
3. Timer Enables:
  - step_timer is enabled when enable_motor_in is high AND op_mode_in is Static or PWM (since these modes use the 6-step commutation sequence).
  - pwm_carrier_timer is enabled when enable_motor_in is high AND op_mode_in is PWM or SPWM (as these modes require a PWM carrier).
4. load_period for Timers: I've tied load_period to 1'b1 for simplicity. This implies the timer always tries to use the current period_value_in. In a real system, you might have a separate mechanism (e.g., a "configuration update" pulse from the register_file when a period register is written) to trigger load_period. For continuous operation where the period might change on the fly, this continuous load is acceptable.
5. Internal Signals:
  - internal_step_period_match_tick (from step_timer) now drives the commutation FSM.
  - internal_pwm_timer_count (from pwm_carrier_timer) now drives the PWM comparison logic.
6. PWM Output Logic Correction: In MODE_PWM, when a phase is active, only its ideal_hs_X_out should be PWMing. The other two ideal_hs_Y_out and ideal_hs_Z_out must be '0' to correctly allow the complementary low-side FETs to operate or to keep other phases off. I've adjusted the case statement in MODE_PWM to reflect this properly (e.g., for state 3'd0, only ideal_hs_u_out is assigned the PWM comparison, v and w remain at their default of 0).

Testbench Update (tb_pwm_generator_with_timers.v):

Your new testbench will need to:

- Remove the direct simulation of step_period_match_tick_in_tb and pwm_timer_count_in_tb.
- Instead, provide values for step_duration_period_in_tb and pwm_carrier_period_in_tb.
- The rest of the stimulus (enable, direction, op_mode, OC values) would remain similar.

### Revised pwm_waveform_generator.v to align with the new 6-register map

Changes:

1. Port List Updated:
  - Removed oc_u_val_in, oc_v_val_in, oc_w_val_in.
  - Added input wire [15:0] generic_pwm_duty_val_in;.
2. MODE_PWM Logic in always @(*) Block:
  - The case (commutation_state) structure is still used.
  - For each state, only the ideal_hs_X_out corresponding to the active high-side phase for that state is assigned the PWM generation logic: (internal_pwm_timer_count < generic_pwm_duty_val_in).
  - The ideal_hs_out signals for the other two phases will automatically be 1'b0 because they are defaulted to 0 at the beginning of the always @(*) block and are not assigned any other value in the non-active cases within MODE_PWM. This is a cleaner way to write it than explicitly assigning them to 0 in each case.

Changes in the Testbench:

1. Module Name: Changed to tb_pwm_generator_with_timers_generic_duty for clarity.
2. VCD Filename: Changed to tb_pwm_gen_timers_generic_duty.vcd.
3. Removed oc_u_val_in_tb, oc_v_val_in_tb, oc_w_val_in_tb: These reg declarations are gone.
4. Added generic_pwm_duty_val_in_tb: This new reg will supply the single duty cycle value.
5. DUT Instantiation (UUT):
  - The connections for .oc_u_val_in(), .oc_v_val_in(), .oc_w_val_in() are removed.
  - The new connection .generic_pwm_duty_val_in(generic_pwm_duty_val_in_tb) is added.
6. Initialization: generic_pwm_duty_val_in_tb is initialized (e.g., to give a 50% duty cycle).
7. Test Cases:
  - Display messages are updated to show the generic_pwm_duty_val_in_tb.
  - Test Case 5 now updates generic_pwm_duty_val_in_tb when new timer periods are set.
  - Added Test Case 5b to specifically test changing only the generic_pwm_duty_val_in_tb while the motor is running in PWM mode, to see the duty cycle change dynamically.

### Revised pwm_waveform_generator.v to include SPWM

1. New Input Port: Added input wire [31:0] spwm_config_in.
2. spwm_engine Instantiation: Added the spwm_engine_inst instance.
3. SPWM Engine Enable: The .enable port of the spwm_engine is driven by enable_motor_in && (op_mode_in == MODE_SPWM). This ensures it's only active when needed, preventing unnecessary calculations.
4. MODE_SPWM Case Filled In: The case statement for op_mode_in now has the logic for MODE_SPWM. It uses the spwm_oc_u, spwm_oc_v, and spwm_oc_w outputs from the spwm_engine_inst to generate the final PWM comparisons.
5. SPWM Direction Control: A simple if (!direction_in) statement handles reversing the motor direction in SPWM mode by swapping the V and W phase outputs, which is a standard technique.

How this Testbench Works:

1. Instantiation: It instantiates only the pwm_waveform_generator, which now contains the timers and the SPWM engine internally.
2. Inputs: It drives all the necessary configuration inputs (op_mode_in, period values, duty value, SPWM config).
3. Stimulus Flow: The testbench walks through each of the three modes sequentially:
  - Test 1 (Static): Sets op_mode_in_tb = 2'b00.
  - Test 2 (PWM): Sets op_mode_in_tb = 2'b01.
  - Test 3 (SPWM Fwd): Sets op_mode_in_tb = 2'b10.
  - Test 4 (SPWM Rev): Keeps op_mode_in_tb at 2'b10 but toggles direction_in_tb.
  - It also tests the enable/disable functionality.
4. Verification: Verification is done by observing the three ideal_hs_..._out_tb signals in GtkWave.

### Module: brake_logic.v

Purpose:
To take the 6 conditioned PWM signals (after dead-zone insertion) and, if a brake condition is active, override them with a predefined braking pattern. Otherwise, it passes the normal PWM signals through.

Inputs:

- clk (System clock or PWM clock - typically doesn't need to be high speed, as logic is mostly combinational or simple state). Let's assume clk_pwm for now.
- rst_n
- From dead_zone_inserter.v (Normal operation signals):
  - pwm_hs_u_in, pwm_ls_u_in
  - pwm_hs_v_in, pwm_ls_v_in
  - pwm_hs_w_in, pwm_ls_w_in
- From register_file.v (Software brake control):
  - sw_brake_enable_in: Software command to enable brake.
  - sw_brake_pattern_in [1:0]: Defines the software-commanded brake pattern.
- From FPGA I/O Pin (Hardware emergency brake):
  - hw_brake_pin_in: Direct input from an external brake button/signal.
- From register_file.v (Enable for hardware brake):
  - hw_brake_pin_enable_in: Enables the hw_brake_pin_in to activate the brake.

Outputs:

- To FPGA I/O Pins (Final 6 PWM signals):
  - final_pwm_hs_u_out, final_pwm_ls_u_out
  - final_pwm_hs_v_out, final_pwm_ls_v_out
  - final_pwm_hs_w_out, final_pwm_ls_w_out
- To register_file.v (Status):
  - brake_active_status_out: Indicates if any brake condition is currently active.

Internal Logic:

1. Determine if Brake is Active:
  - Brake is active if:
    - (sw_brake_enable_in is HIGH)
    - OR (hw_brake_pin_in is HIGH AND hw_brake_pin_enable_in is HIGH)
2. Select Brake Pattern:
  - If software brake is the primary cause (sw_brake_enable_in is HIGH), use sw_brake_pattern_in.
  - If hardware brake is the cause (and software brake is not enabled), you might have a fixed hardware brake pattern or use the sw_brake_pattern_in as well. For simplicity, let's assume the hardware brake uses a predefined pattern if not overridden by sw_brake_pattern_in when sw_brake_enable_in is also active.
  - A common approach is that hw_brake_pin_in (if enabled) forces a specific, often aggressive, brake pattern, and sw_brake_enable_in allows selection from sw_brake_pattern_in. If both are active, hw_brake_pin_in might take precedence or they might combine if their patterns are compatible.

Let's refine:

  - final_brake_active = sw_brake_enable_in || (hw_brake_pin_in && hw_brake_pin_enable_in);
  - If final_brake_active is true:
    - Determine the effective brake pattern. Let's prioritize: If sw_brake_enable_in is active, use sw_brake_pattern_in. Else if hw_brake_pin_in && hw_brake_pin_enable_in is active, use a default hardware pattern (e.g., all LS ON, all HS OFF).
    - Brake Patterns (from your register_file.v definition):
      - 00: All Off (Coast) -> All 6 outputs = 0.
      - 01: All HS Off / All LS On (Dynamic Braking) -> HS_U/V/W = 0, LS_U/V/W = 1.
      - 10, 11: Reserved (Treat as "All Off" for safety).
    - Let's define a fixed pattern for the hardware brake if it's the sole trigger: pattern 01 (All LS On).
3. Output Multiplexing:
  - If final_brake_active is true, output the signals corresponding to the selected brake pattern.
  - Otherwise, pass through pwm_hs_X_in and pwm_ls_X_in to final_pwm_hs_X_out and final_pwm_ls_X_out

Key Design Choices and Points:

1. Combinational Logic: The core logic is combinational (always @(*) and assign statements). This means the outputs change as soon as the inputs change (after some propagation delay). This is generally fine for brake logic.
2. final_brake_active: This wire determines if any brake condition is met.
3. brake_active_status_out: Directly reflects final_brake_active. If you needed this status to be latched (e.g., for interrupt generation if the brake condition was momentary), you'd register it.
4. current_brake_pattern:
  - If sw_brake_enable_in is true, it uses sw_brake_pattern_in. This gives software explicit control over the pattern.
  - If sw_brake_enable_in is false, but effective_hw_brake_active is true (hardware pin triggered), it defaults to pattern 2'b01 (All LS On / All HS Off).
  - If no brake is active, this signal's value doesn't strictly matter as final_brake_active will be false, but it defaults to 2'b00.
5. Output Multiplexing: The always @(*) block selects either the brake pattern outputs or passes through the normal PWM signals based on final_brake_active.
6. Reserved Patterns: Safely default to "All Off".
7. clk and rst_n: Currently, clk and rst_n are not strictly used by the combinational logic but are included as good practice in case you want to add registered elements later (like a latched status). If it remains purely combinational, they could be removed from the port list, but it's often kept for module consistency.

Explanation of the Testbench:

1. apply_dummy_pwm_cycle Task: A simple helper task to wiggle the pwm_..._in_tb signals. This makes the test cases cleaner as we can call this task to provide some input activity. The patterns are arbitrary, just to have non-zero inputs.
2. Initialization: Sets all brake controls to inactive initially.
3. Test Case 1 (No Brake): Verifies pass-through behavior.
4. Test Case 2 (SW Brake - All Off): Enables software brake with pattern 00.
5. Test Case 3 (SW Brake - All LS On): Enables software brake with pattern 01.
6. Test Case 4 (HW Brake): Enables the hardware brake functionality and asserts the hardware brake pin. The output should be the default hardware brake pattern (all LS on, as per brake_logic.v).
7. Test Case 5 (HW Brake Pin Not Enabled): Asserts the hardware brake pin but keeps its enable low. Brake should not activate.
8. Test Case 6 & 7 (Precedence/Interaction): Tests scenarios where both software and hardware brake conditions might be present to verify the priority logic in brake_logic.v. (Your current brake_logic.v gives SW pattern priority if SW enable is on).
9. $error checks: Simple checks for brake_active_status_out_tb. More rigorous checks would compare all 6 output PWMs to expected values for each pattern.

### Module: icb_interface.v

This module's job is to be a translator. It receives complex, timed bus transactions from the E203 CPU (the ICB master) and translates them into simple, single-cycle read and write signals for our register_file.v.

The Logic: A Step-by-Step Breakdown

1. Address Decoding: When a command arrives on the bus (icb_cmd_valid is high), the first thing we do is check the address.
  - We'll have a BASE_ADDR parameter. We compare the upper bits of icb_cmd_addr to this base address.
  - If they match, it's a "hit" – the command is for us. If not, we ignore it.
  - The lower bits of icb_cmd_addr (e.g., [4:2]) directly tell us which of our 6 registers is being targeted. This will drive the reg_addr_sel of our register_file.v.
2. Command Handshake (icb_cmd_valid/icb_cmd_ready):
  - The CPU asserts icb_cmd_valid when it has a command.
  - We must assert icb_cmd_ready when we are ready to accept that command.
  - A transaction is "fired" on a clock edge when both are high.
  - A simple and robust strategy is: we are ready (icb_cmd_ready = 1) if the address is a hit AND we are not already busy processing a previous command's response.
3. Response Handshake (icb_rsp_valid/icb_rsp_ready):
  - After we accept and process a command, we must send a response.
  - We assert icb_rsp_valid to signal to the CPU that we have a response ready.
  - The CPU asserts icb_rsp_ready when it's ready to take our response.
  - The response transaction is "fired" when both are high.
  - Latency: A simple design will have a 1-cycle latency. In Cycle 0, the command is accepted. In Cycle 1, the response is presented (icb_rsp_valid goes high).
4. Handling Writes vs. Reads:
  - Write: When a write command fires, we generate a one-cycle reg_write_en pulse to the register_file and pass the icb_cmd_wdata. The response we send back is just an acknowledgement (the data on icb_rsp_rdata doesn't matter for a write).
  - Read: When a read command fires, we drive the reg_addr_sel to the register_file. The register_file's logic is combinational, so its reg_read_data_muxed output will be valid almost immediately. We need to capture this data and present it on icb_rsp_rdata in the next cycle when we assert icb_rsp_valid.

Key Design Points Explained:

1. BASE_ADDR Parameter: Makes the module reusable. You'll set this when you instantiate it in your E203 SoC top file to match the system memory map.
2. addr_hit: This is the gatekeeper. icb_cmd_ready will never go high unless the address is for us.
3. icb_cmd_ready Logic: The expression addr_hit && !rsp_valid_reg is simple and powerful. It prevents us from accepting a new command until the response for the old one has been sent (or at least until we are no longer asserting icb_rsp_valid).
4. cmd_fire Signal: This wire is a useful shorthand to represent the event of a successful command transaction.
5. Pipelined Response:
  - In the always block, when cmd_fire happens, we immediately set rsp_valid_reg <= 1'b1. This means on the next clock edge, icb_rsp_valid will be high. This creates the 1-cycle response latency.
  - We also latch the icb_cmd_read into cmd_read_reg. This is crucial.
  - In the next cycle, when we are presenting the response, we use the latched cmd_read_reg to decide what data to put on rsp_rdata_reg. If cmd_read_reg is high, we take the fresh data from reg_read_data_muxed.
6. Simplicity: This design avoids a complex multi-state FSM by using a single rsp_valid_reg to manage its "busy" state.

Key Features of this ICB Master Testbench:

1. DUT Instantiation: It instantiates both icb_interface and register_file, wiring them together correctly. This tests the path from the ICB bus all the way to the internal registers.
2. ICB Master Tasks (icb_write, icb_read_and_check):
  - These tasks encapsulate the ICB protocol from the master's perspective.
  - They assert icb_cmd_valid.
  - They wait for icb_cmd_ready_dut from the slave before proceeding. This is crucial for correct handshaking.
  - They then wait for the slave's response (icb_rsp_valid_dut).
3. Correct Addressing: All tasks use the DUT_BASE_ADDR parameter plus the register offset to form the full 32-bit address, just like real software would.
4. Test Cases:
  - A simple write/readback to verify basic operation.
  - A sequence of writes followed by a sequence of reads to ensure multiple registers can be configured.
  - A read from an invalid (but within range) address to check if you get the DEADBEEF value back from register_file.
  - An access to an address outside the peripheral's range (addr_hit should be false) to verify that icb_cmd_ready_dut correctly stays low.
5. Simplicity: It doesn't need to check all the detailed output signals of register_file again (since we did that in tb_register_file.v). The goal here is to confirm that the registers can be accessed correctly via the ICB interface.

What Changed and Why:

1. Removed cmd_read_reg: It was redundant and the source of the pipeline error.
2. Moved rsp_rdata_reg Logic: The assignment to rsp_rdata_reg now happens inside the if (cmd_fire) block. This means in the same clock cycle that we decide to accept a command, we also decide what our response data will be for the next cycle.
3. Correct Timing:
  - When a read command fires (cmd_fire and icb_cmd_read are high), rsp_rdata_reg is loaded with reg_read_data_muxed. At the same time, rsp_valid_reg is set to 1.
  - On the next clock edge, icb_rsp_valid goes high, and icb_rsp_rdata (which is assigned from rsp_rdata_reg) now has the correct data from the read operation.

### Module: bldc_controller.v

Purpose:
To encapsulate the entire BLDC controller logic, presenting an ICB slave interface to the CPU and the final 6 PWM drive signals (plus brake input) to the outside world (FPGA pins).

Internal Structure:
This module will be almost entirely structural, consisting of instantiations of the modules you've already built and the wires connecting them.

1. icb_interface
2. register_file
3. pwm_waveform_generator
4. dead_zone_inserter
5. brake_logic
6. (Remember main_timer.v is now inside pwm_waveform_generator.v, so we don't instantiate it separately at this level).

Connecting the Dots:

- Control Path: icb_interface -> register_file -> pwm_waveform_generator, dead_zone_inserter, brake_logic
- Status Path: brake_logic, pwm_waveform_generator -> register_file
- Data Path: pwm_waveform_generator -> dead_zone_inserter -> brake_logic

Key Design Decisions and Connections in this Top-Level Module:

1. Parameter Propagation: BASE_ADDR is parameterized at the top level and passed down to icb_interface_inst.
2. Clocking (clk): For simplicity, I've connected the main system clk to all modules. In a more advanced design, you might have a clock prescaler at this level to generate a specific clk_pwm for the core logic if the system clk is too fast.
3. Reset (rst_n):
  - The main system rst_n resets all modules.
  - Soft Reset: The soft_reset_internal_out_wire from the register file is used to also reset the pwm_gen_inst's state machine (.rst_n(rst_n & ~soft_reset_internal_out_wire)). This allows software to reset the commutation sequence without resetting the entire peripheral's configuration registers.
4. Status Feedback Loop:
  - brake_logic provides brake_active_status_out which feeds into register_file.
  - pwm_waveform_generator needs a new output port, e.g., commutation_state_out [2:0], to feed its current state back to the STATUS_REG. You will need to add this port to pwm_waveform_generator.v. It would simply be assign commutation_state_out = commutation_state;.
  - Other status signals are simply looped back from their control signals for now (motor_enabled_actual_hw_in, current_op_mode_hw_in), which is a reasonable simplification until fault detection logic is added.
5. Data Path Wiring: The flow is clearly wired: pwm_gen_inst -> dz_inst -> brake_inst -> top-level outputs.

Key Features of this Full System Testbench:

1. Instantiates bldc_controller: The single, complete DUT.
2. ICB Master Tasks: The same robust icb_write and icb_read tasks are used to interact with the DUT's bus interface.
3. Scenario-Based Testing: Instead of just testing individual registers, the stimulus is structured into realistic scenarios:
  - Start the motor in a specific mode.
  - Change parameters on the fly (speed, duty cycle).
  - Switch operating modes.
  - Engage the brake.
  - Disable the motor.
4. Verification: The primary verification is done by observing the final 6 PWM outputs in GtkWave. You are no longer just checking if a register holds a value; you are checking if that value propagated through the entire system and produced the correct physical output.

NOW WE IMPLEMENT THE SPWM MODE

# References

Hummingbirdv2 E203 Core and SoC – Link (https://doc.nucleisys.com/hbirdv2/index.html)
