FlavioDB/FPGA-Based-BLDC-Motor-Controller-with-RISC-V-SoC/Appendix/Class Notes/Class Notes 2.jpg

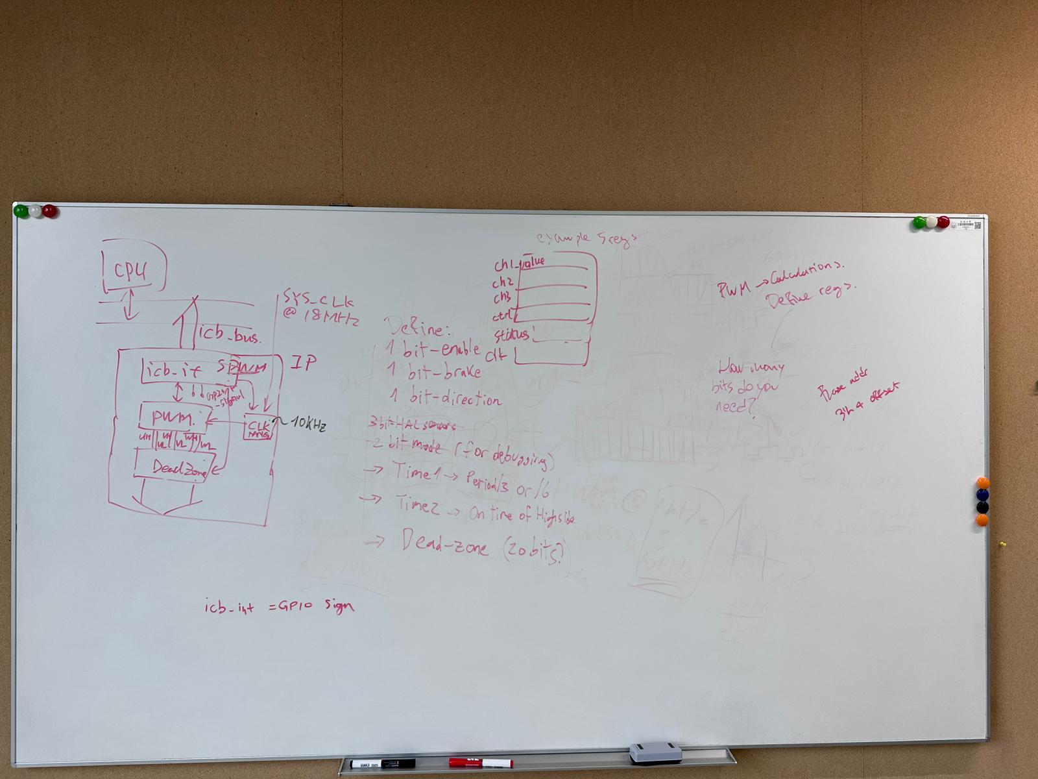
Appendix/Class Notes/Class Notes 2.jpg
