FlavioDB/FPGA-Based-BLDC-Motor-Controller-with-RISC-V-SoC/Screenshots_Waveforms/Brakes/Brake_Waveforms_1outof1.jpg

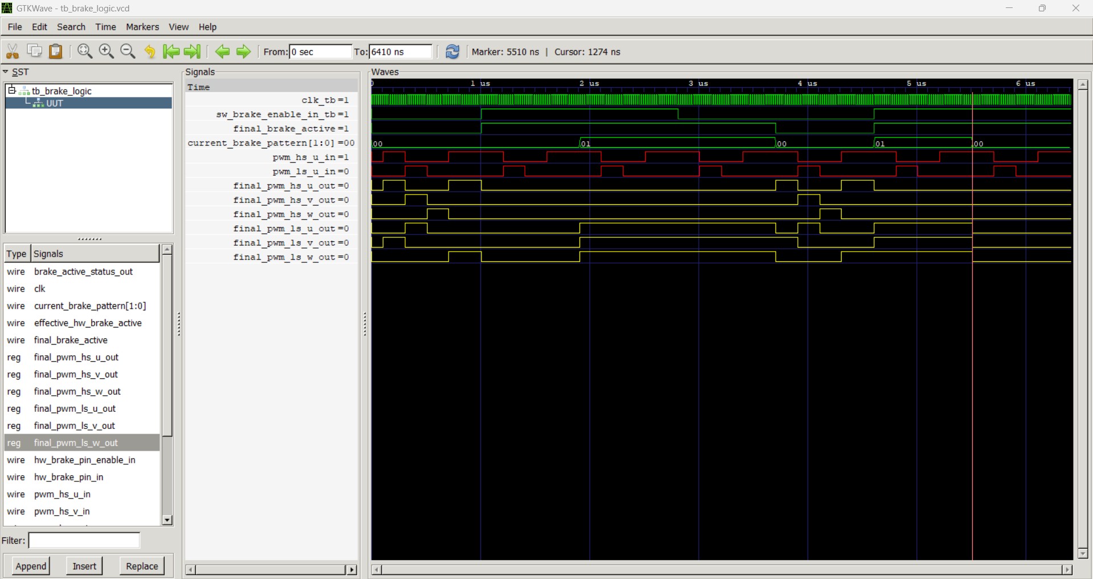
Screenshots_Waveforms/Brakes/Brake_Waveforms_1outof1.jpg
