FlavioDB/FPGA-Based-BLDC-Motor-Controller-with-RISC-V-SoC/Screenshots_Waveforms/Dead_time/Dead_time_waveforms.jpg

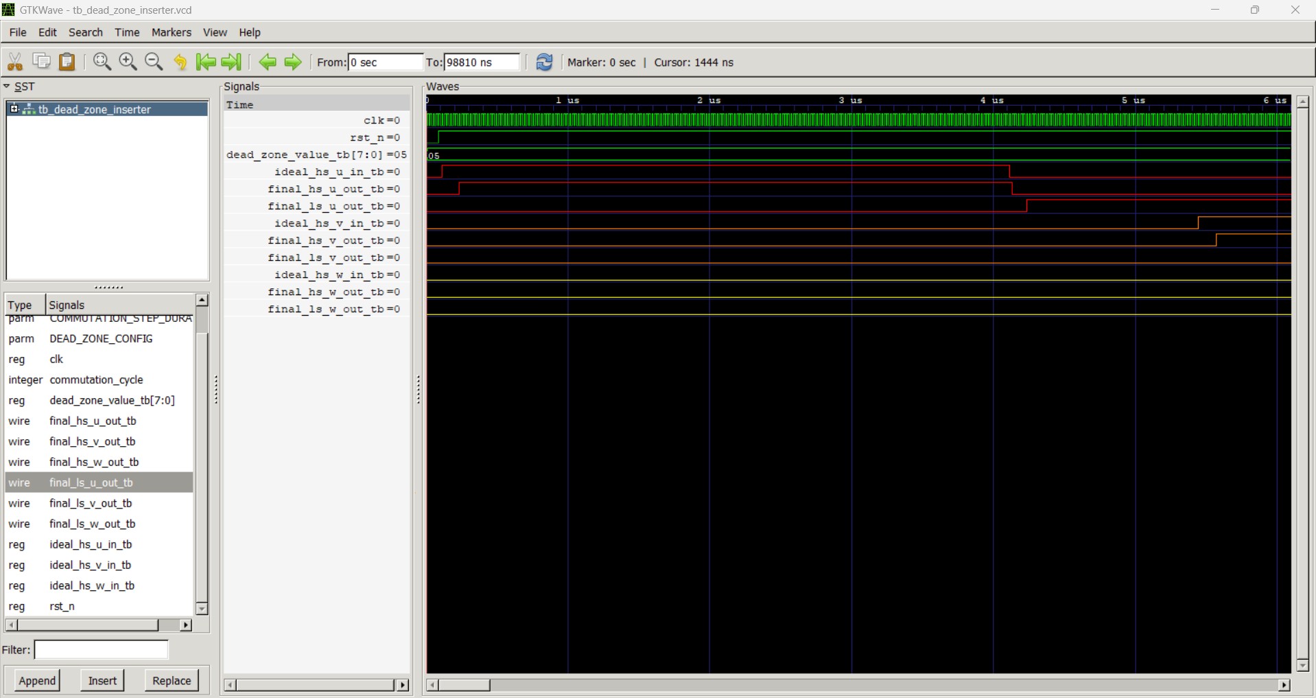
Screenshots_Waveforms/Dead_time/Dead_time_waveforms.jpg
