FlavioDB/FPGA-Based-BLDC-Motor-Controller-with-RISC-V-SoC/Appendix/H-bridge contrroler schematics.pdf

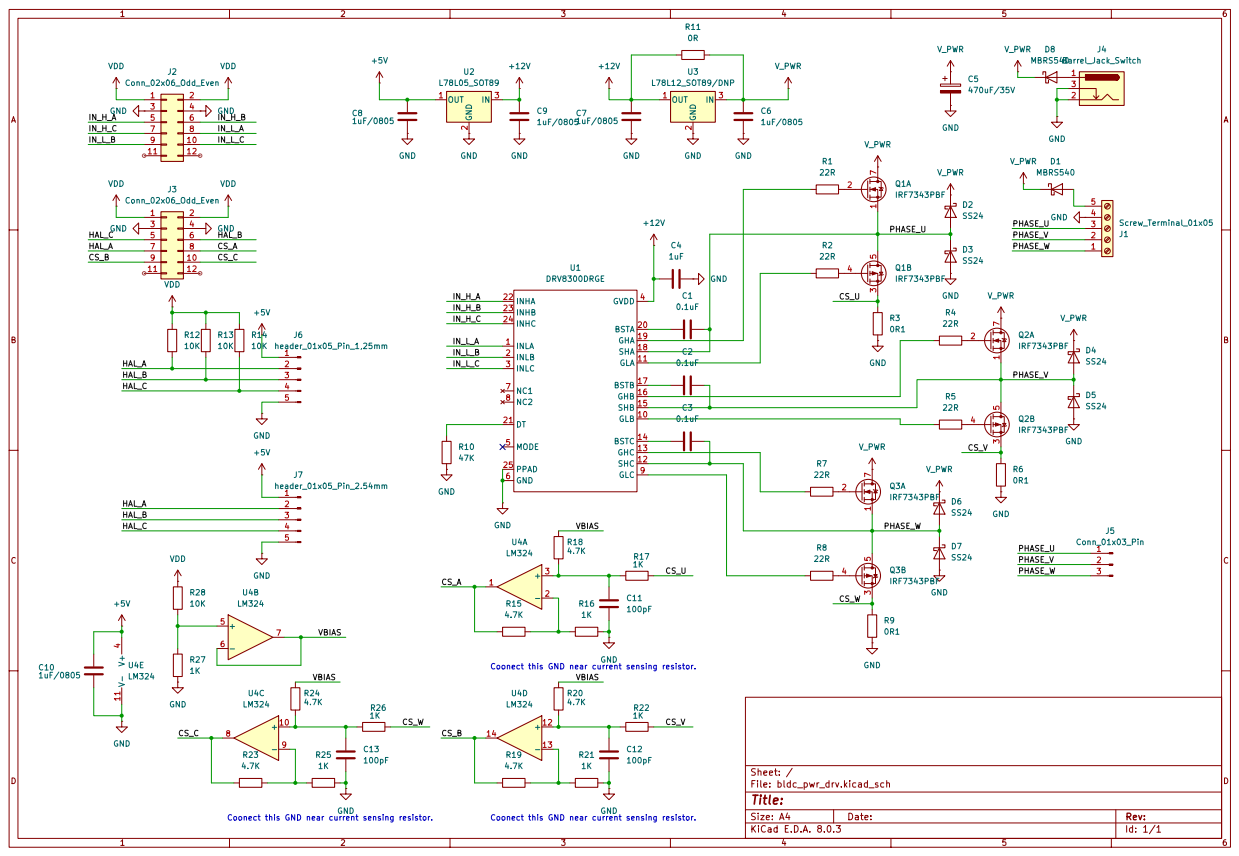
[picture p40: page 1]
